Britoshi/MagicMillipod/StateMachine.hpp

#pragma once
#include "StateFactory.hpp"

class State;

class StateMachine
{
    friend class State;
public:
    State *currentState = nullptr;

    StateMachine();
    ~StateMachine();

    void Update();
    void ResetToIdle();
    void EnterCalibration();
    void AdvanceToNextState();

public:
    StateFactory factory;
};
