Britoshi/MagicMillipod/IntroductionState.hpp

#pragma once
#include "State.hpp"

class IntroductionState : public State
{
public:
    explicit IntroductionState(StateMachine *context, State *superState = nullptr)
        : State(context, superState) {}

    ~IntroductionState() = default;

protected:
    void OnStateEnter() override;
    void OnStateExit() override;
    void OnStateUpdate() override;

    bool CheckSwitchState() override;
    void InitializeSubState() override;

private:
    static constexpr double DURATION               = 52.0;
    static constexpr double FADE_DURATION          = 10.0;
    static constexpr double FADE_OFFSET            = 5.0; 
    double _enterTime       = 0.0;
    double _personLeftTime  = -1.0;
    bool   _personSeen      = false;
};
