Britoshi/MagicMillipod/PlayAudioState.hpp

#pragma once
#include "State.hpp"

class PlayAudioState : public State
{
public:
    explicit PlayAudioState(StateMachine *context, State *superState = nullptr)
        : State(context, superState) {}

    ~PlayAudioState() = default;

protected:
    void OnStateEnter() override;
    void OnStateExit() override;
    void OnStateUpdate() override;

    bool CheckSwitchState() override;
    void InitializeSubState() override;

private:
    static constexpr double PLAY_DURATION = 60.0*8.0;
    double _enterTime = 0.0;
    float _lastDistance = -1.0f;
};
