Britoshi/MagicMillipod/(commit log)

2026-03-05 Add audio support and basic state classes
    Add preliminary audio integration and a simple hierarchical state system.
    - Added AdafruitAudio.hpp/cpp: lightweight AdafruitAudio class with public API (Begin, Play, Stop, Pause, Resume, volume/status queries). Methods are currently stubs/placeholders.
    - Updated MagicMillipod.ino: initialize Serial1 and integrate Adafruit_Soundboard (SetupAudio, PlayTrack) and call SetupAudio() from setup(). Kept Time manager usage.
    - Added State.hpp, State.cpp and StateMachine.hpp: basic hierarchical State class (Enter/Exit/Update, SwitchState, sub/super-state handling) and a StateMachine interface with currentState and Update declaration.
    Notes: implementations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
2026-04-15 Fixing Sound boar dplayer
    [DistanceSensorManager.cpp, DistanceSensorManager.hpp, MagicMillipod.ino, PlayAudioState.hpp, StateFactory.hpp, StateMachine.hpp]
2026-04-26 Refactor states; add NeoPixel, multi-track audio
    Replace old Standby/PlayAudio state model with Idle/Introduction/Presentation states and update state factory/machine to start in Idle. Add NeoPixelController (two rings) and replace LEDController usage; implement visual behaviors in new state files. Update AdafruitAudio to support two trigger pins and PlayTrack/Reset behavior (remove .cpp stub). Add Presentation and Introduction logic, Idle suppression logic, and a hardware reset button handler in MagicMillipod.ino. Small fixes: non-allocating time comparison in DistanceSensorManager, distance debug logging, and expose StateMachine::ResetToIdle. Add README documenting architecture and hardwar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
    [DistanceSensorManager.cpp, DistanceSensorManager.hpp, IdleState.cpp, IdleState.hpp, IntroductionState.cpp, IntroductionState.hpp, MagicMillipod.ino, NeoPixelController.hpp]
2026-04-26 LED to Neopixel COnverted + Switch Controller
2026-04-27 Add long-distance averaging and Simple Mode
    Introduce a long rolling buffer (60 samples, ~3s) to DistanceSensorManager with GetLongAverageDistance(), and use it for stable room-exit detection. Add a Simple Mode (DIP switch 0) that bypasses calibration and treats distances >= 50 cm as "empty"; states (Introduction, Presentation, ExitRoom) now consult the switch to choose between calibrated logic and the simple threshold. Update Idle to use a fixed 30 cm hand-trigger and remove the previous suppression/priming logic. Add SIMPLE_EXIT_DISTANCE_CM and TRIGGER_DISTANCE_CM constants, include SwitchController where needed, and update documentation (README and staff guide) to describe wiring, switche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
    [DistanceSensorManager.cpp, DistanceSensorManager.hpp, ExitRoomState.cpp, ExitRoomState.hpp, IdleState.cpp, IdleState.hpp, IntroductionState.cpp, IntroductionState.hpp]
2026-04-30 Persist calibration & visits; add fades and skip mode
    Add LittleFS-backed persistence for calibration and visit counts (CalibrationData::Save/Load, VisitCounter). Initialize and clamp distance sensor buffers, ignore no-echo readings, and pre-fill buffers to avoid startup false triggers. Implement NeoPixel per-ring fade helpers and use them to fade in ExitRoom lights; optimize UV logging to only print on duty changes. Add DIP switch 1 "Skip Left-Room Check" behavior and a short-press state-skip (AdvanceToNextState) while preserving long-press reset semantics. Wire VisitCount increment in Introduction, call VisitCount.Begin and load calibration on setup, and update docs/staff guide/README to r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
    [CalibrationData.hpp, CalibrationState.cpp, DistanceSensorManager.cpp, ExitRoomState.cpp, ExitRoomState.hpp, IntroductionState.cpp, MagicMillipod.ino, NeoPixelController.hpp]
